kjaidev/Statistical-Characterization-Gm-C-Filter/README.md

# Statistical Characterization of a Gm-C Continuous-Time Filter in SKY130
Monte Carlo and PVT-corner study (BAECE203, VIT Chennai).
Team: Jaidev K, S Jai Akaash, Mohanakrishnan S, Jeswant P M. Guide: Dr. Brintha Therese A.

## Run the simulator (safe mode)
    GMC_FAKE=1 streamlit run apptest/gmc_app.py
Safe mode: Live tab is synthetic; other seven tabs read real saved results.

## Real live runs
Needs Docker image hpretl/iic-osic-tools (ngspice + SKY130A).
