kjaidev/Statistical-Characterization-Gm-C-Filter/fig_cm_compare.png

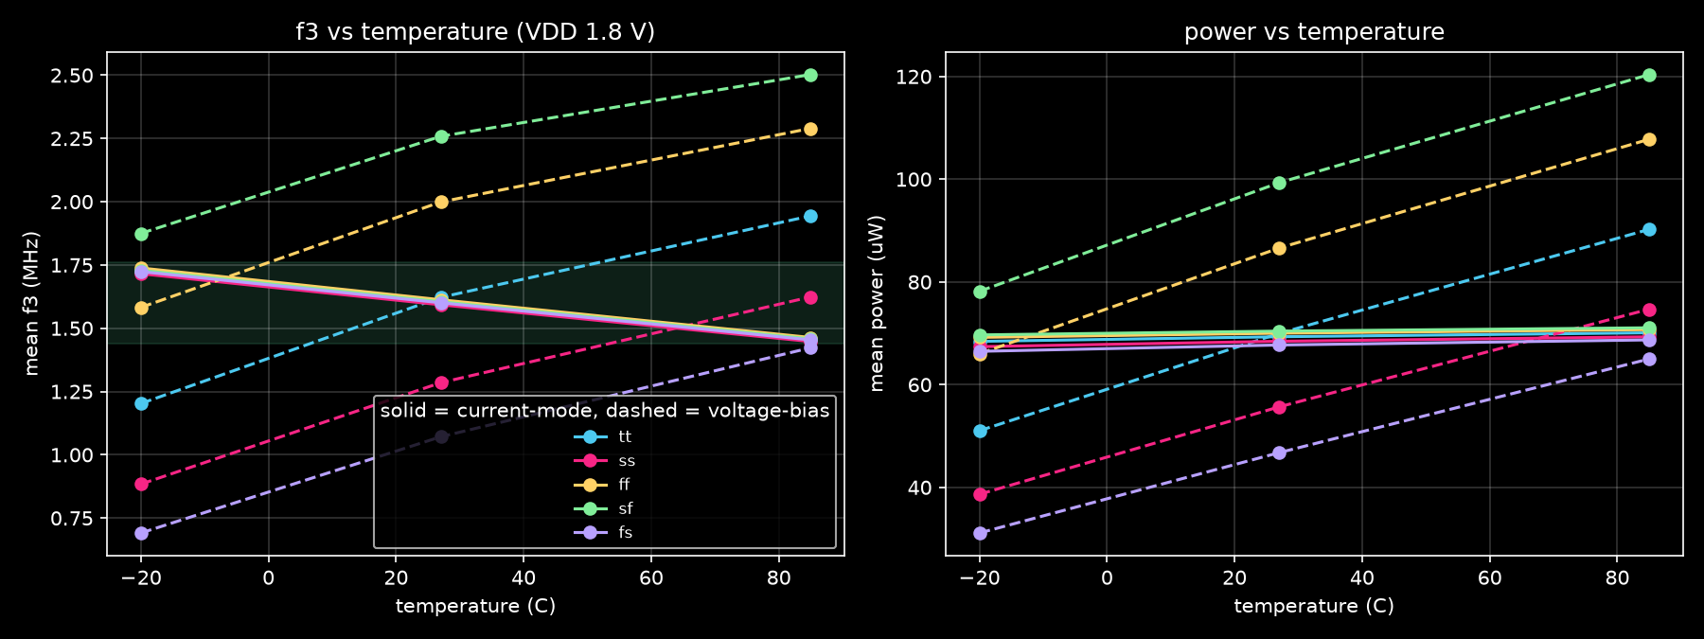
fig_cm_compare.png
