kjaidev/Statistical-Characterization-Gm-C-Filter/fig_cm_range.png

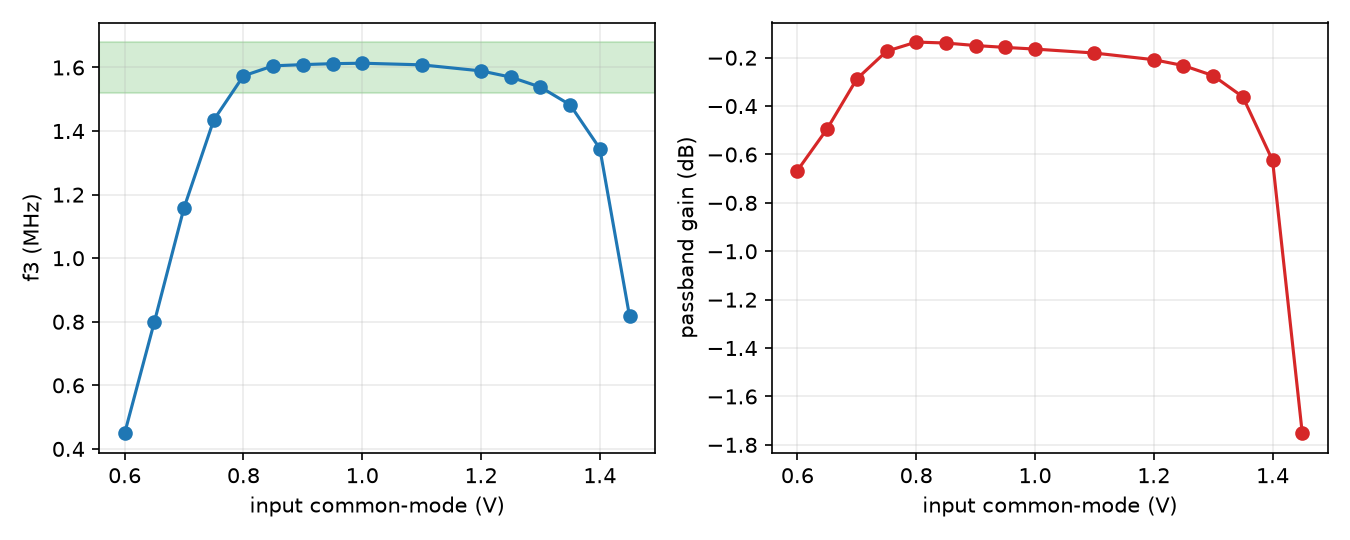
fig_cm_range.png
