kjaidev/Statistical-Characterization-Gm-C-Filter/fig_f3_corners.png

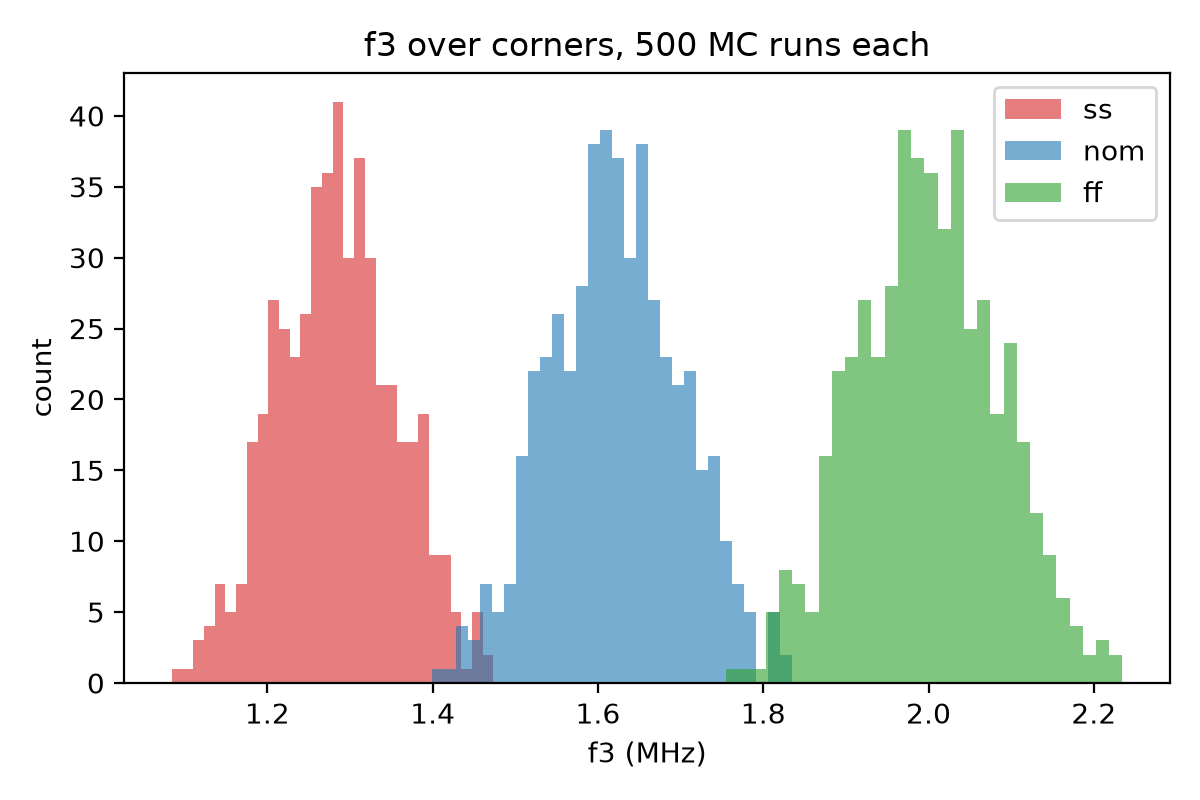
fig_f3_corners.png
