kjaidev/Statistical-Characterization-Gm-C-Filter/fig_grid_f3.png

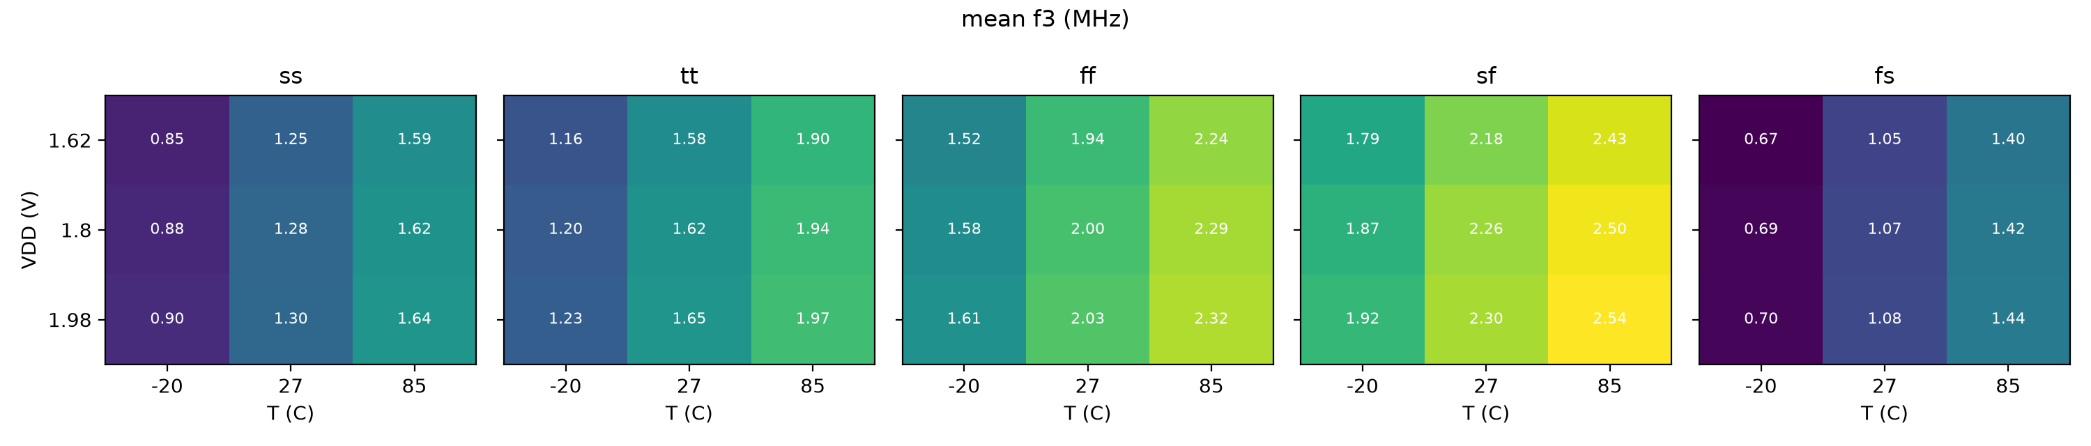
fig_grid_f3.png
