kjaidev/Statistical-Characterization-Gm-C-Filter/fig_grid_q.png

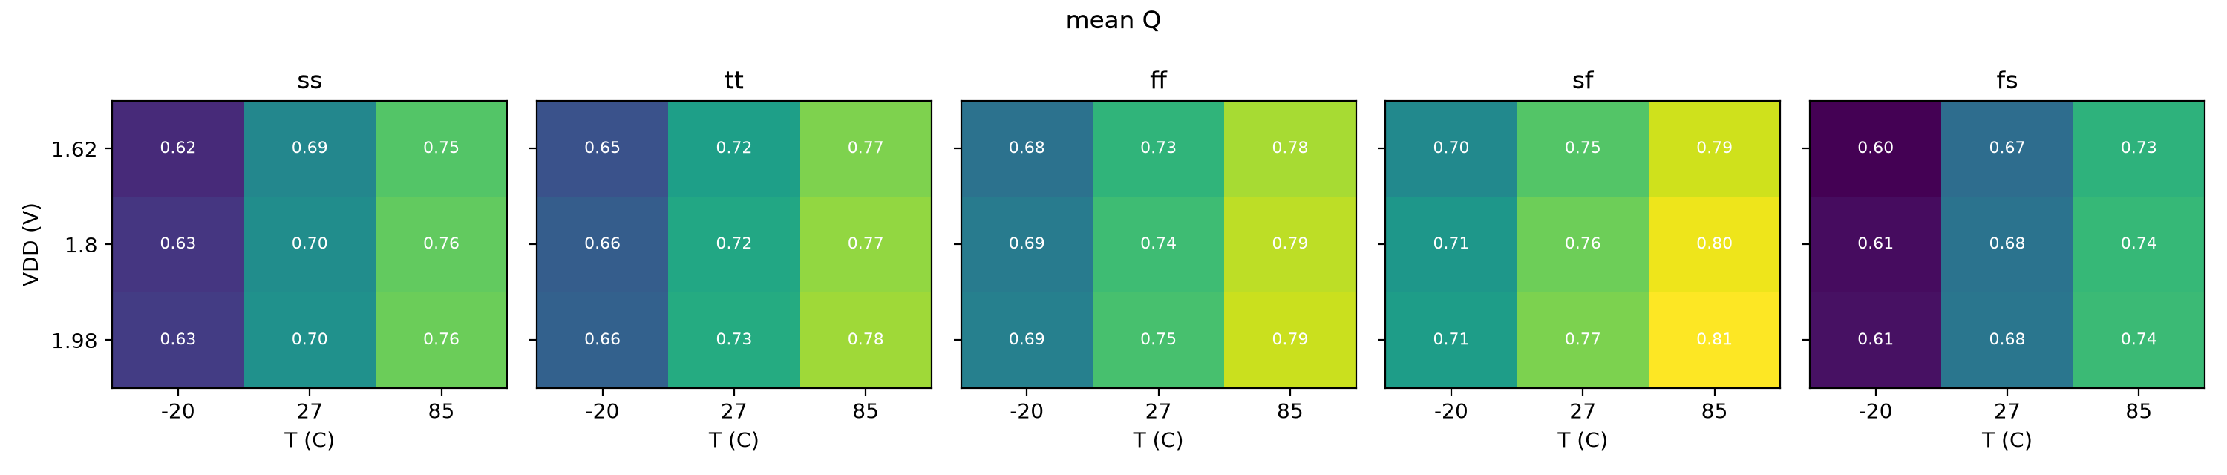
fig_grid_q.png
