kjaidev/Statistical-Characterization-Gm-C-Filter/fig_grid_yield.png

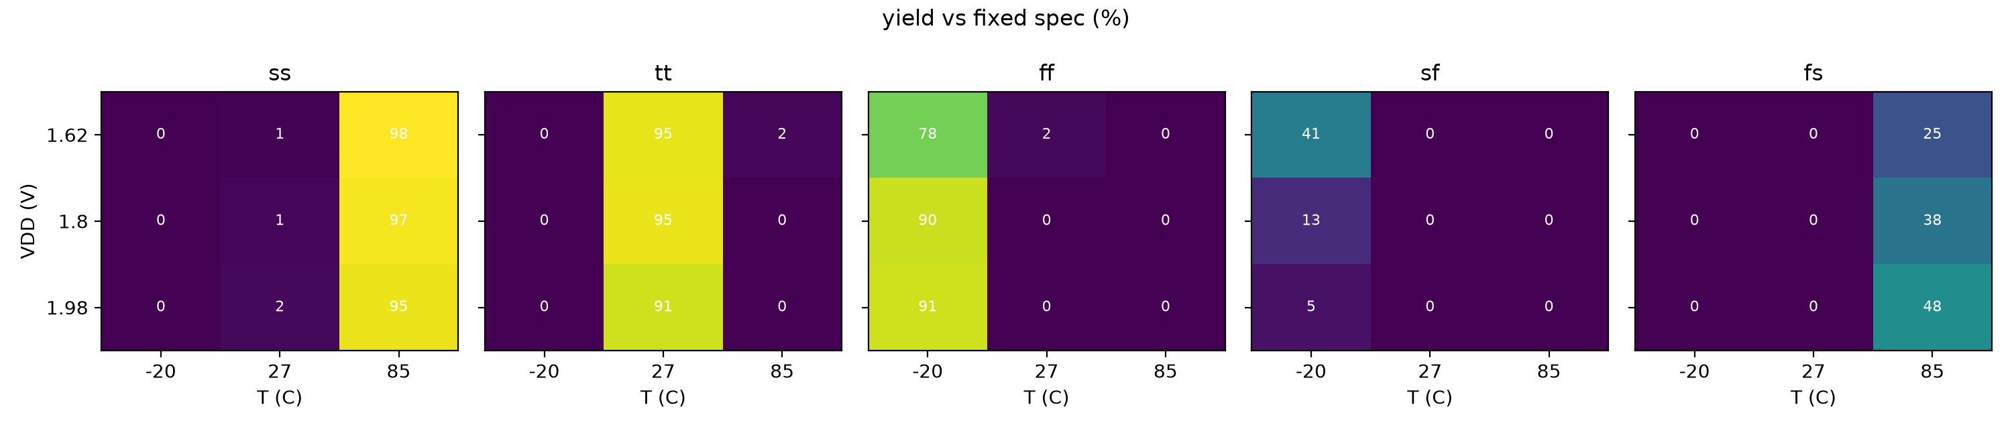
fig_grid_yield.png
