kjaidev/Statistical-Characterization-Gm-C-Filter/fig_noise.png

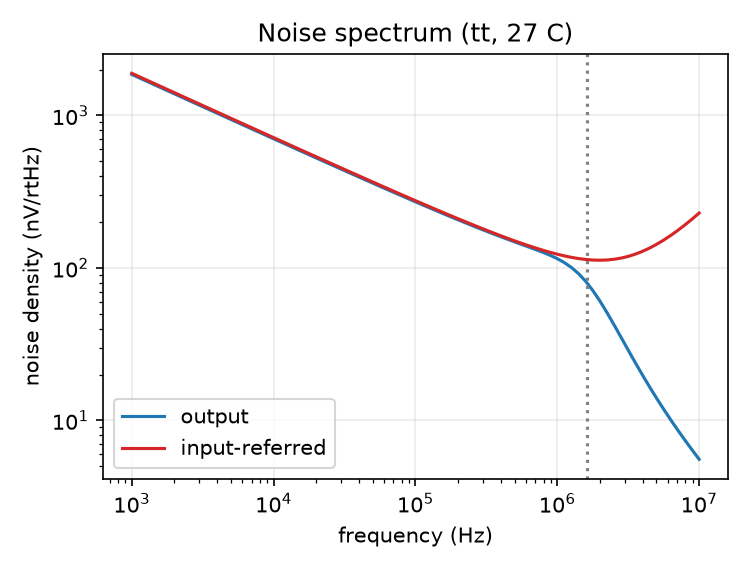
fig_noise.png
