kjaidev/Statistical-Characterization-Gm-C-Filter/fig_nominal_ac.png

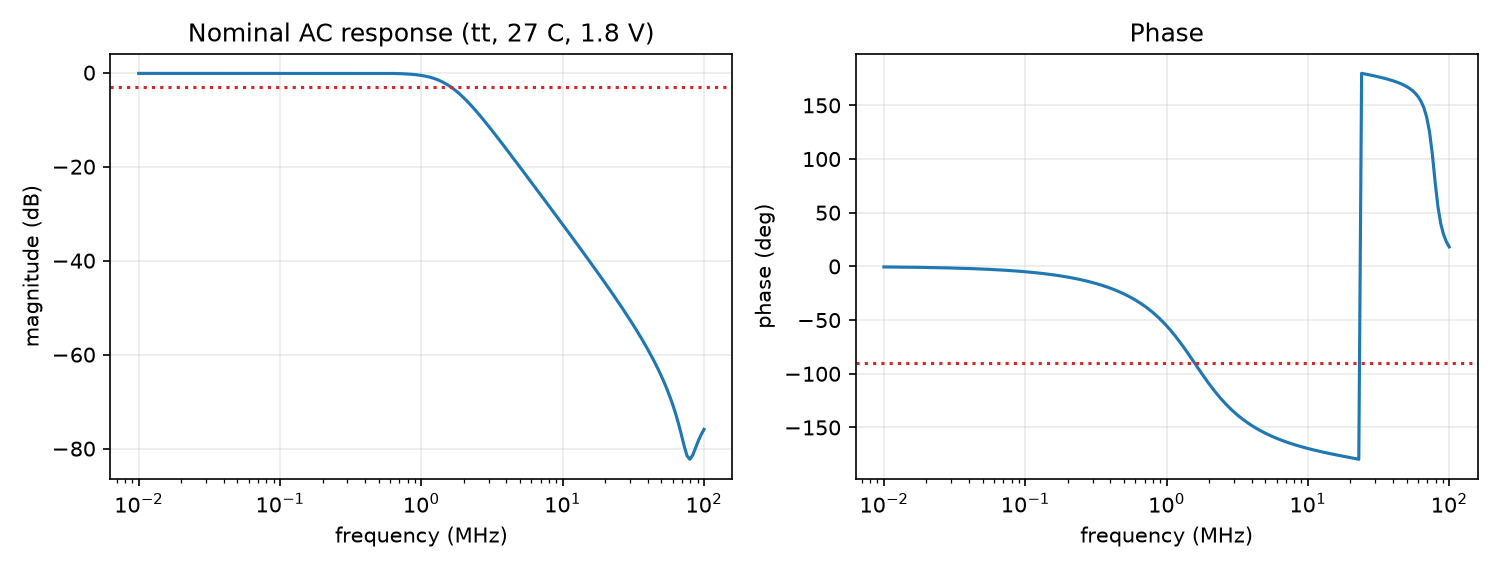
fig_nominal_ac.png
