kjaidev/Statistical-Characterization-Gm-C-Filter/fig_nominal_hist.png

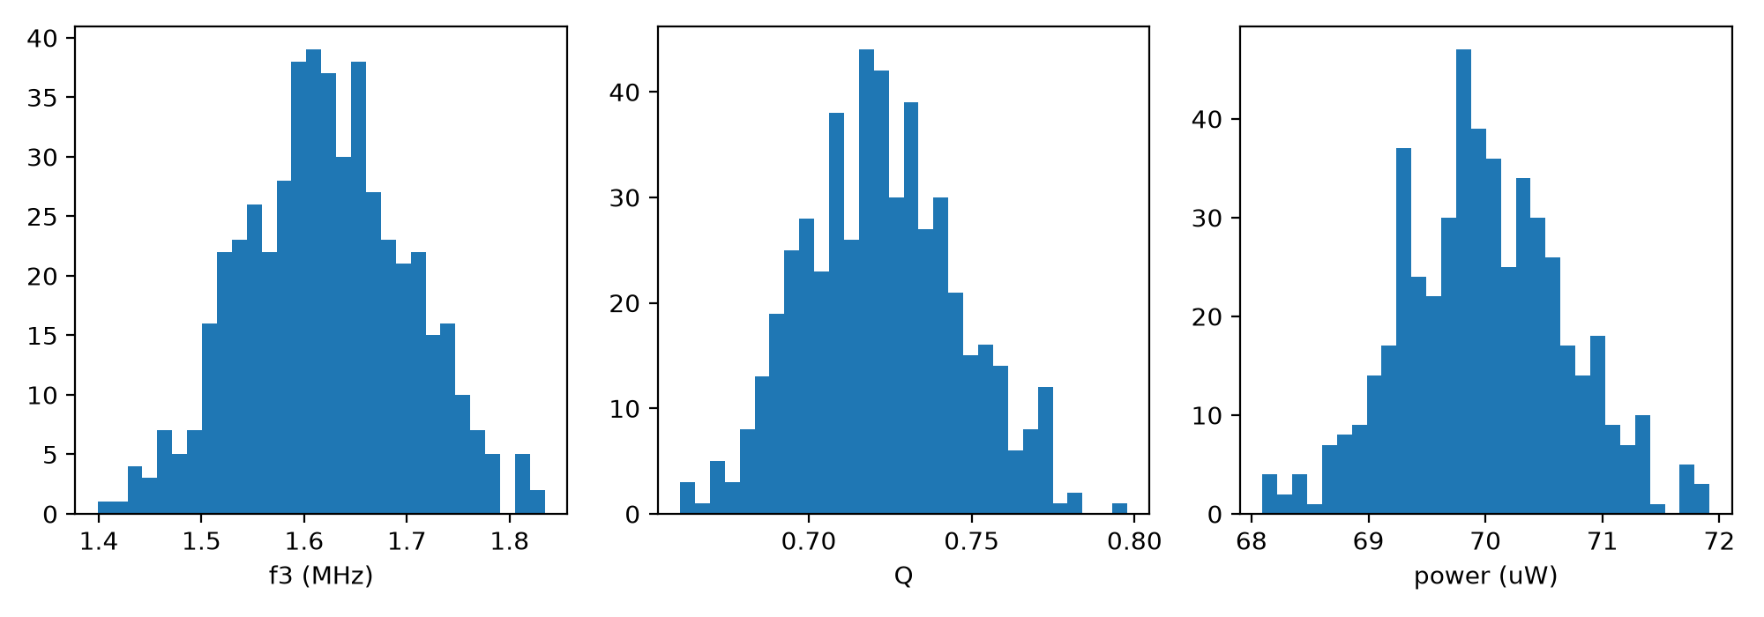
fig_nominal_hist.png
