kjaidev/Statistical-Characterization-Gm-C-Filter/fig_offset_hist.png

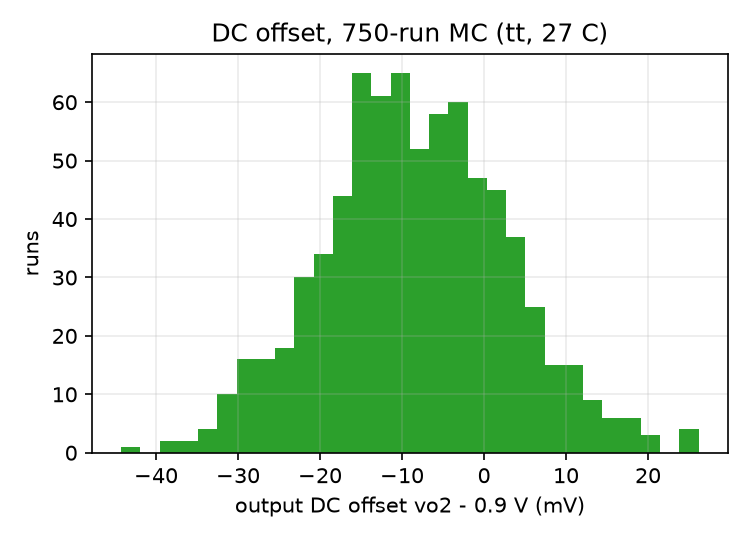
fig_offset_hist.png
