kjaidev/Statistical-Characterization-Gm-C-Filter/fig_pelgrom.png

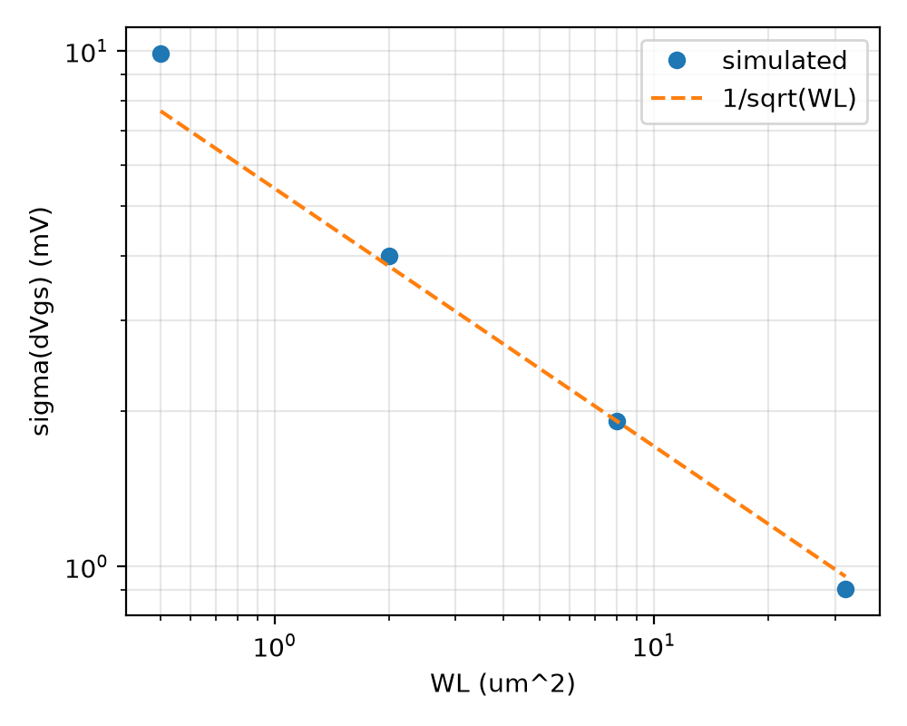
fig_pelgrom.png
