kjaidev/Statistical-Characterization-Gm-C-Filter/fig_pelgrom_handcalc.png

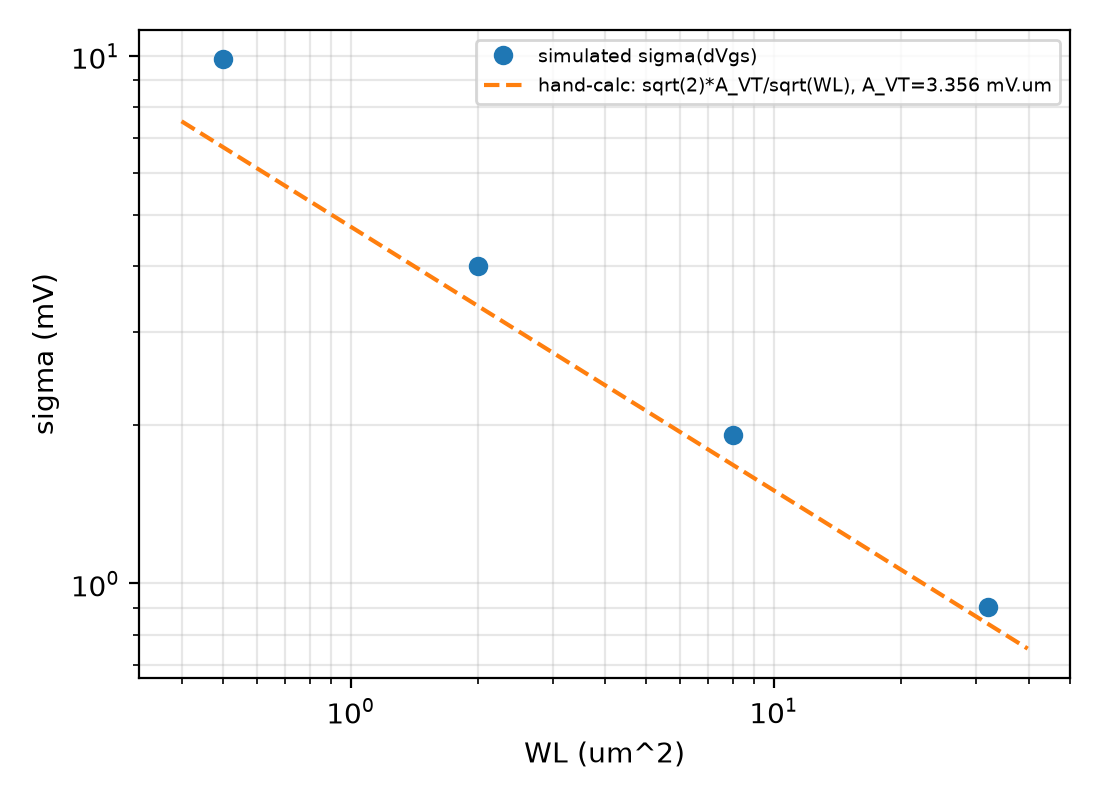
fig_pelgrom_handcalc.png
