kjaidev/Statistical-Characterization-Gm-C-Filter/fig_pt_compare.png

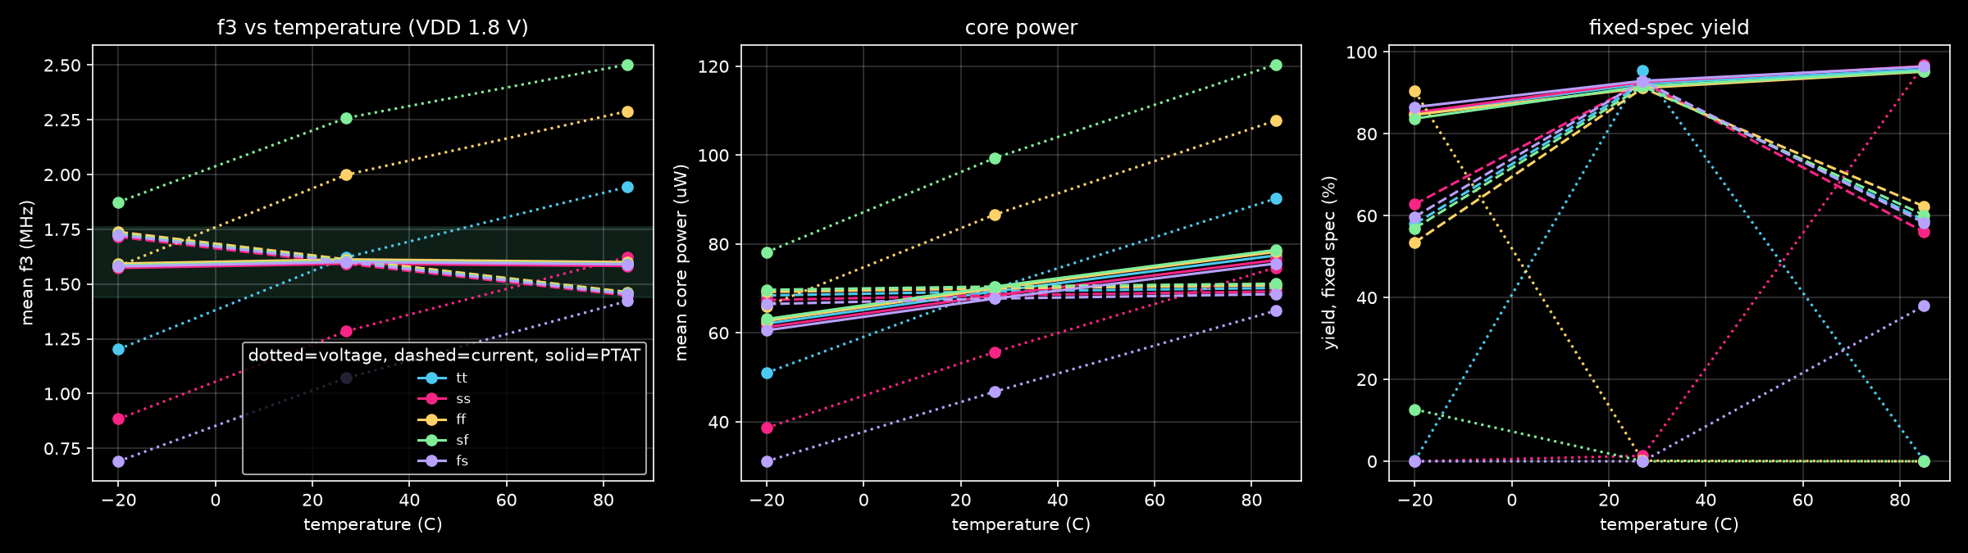
fig_pt_compare.png
