kjaidev/Statistical-Characterization-Gm-C-Filter/fig_pvt.png

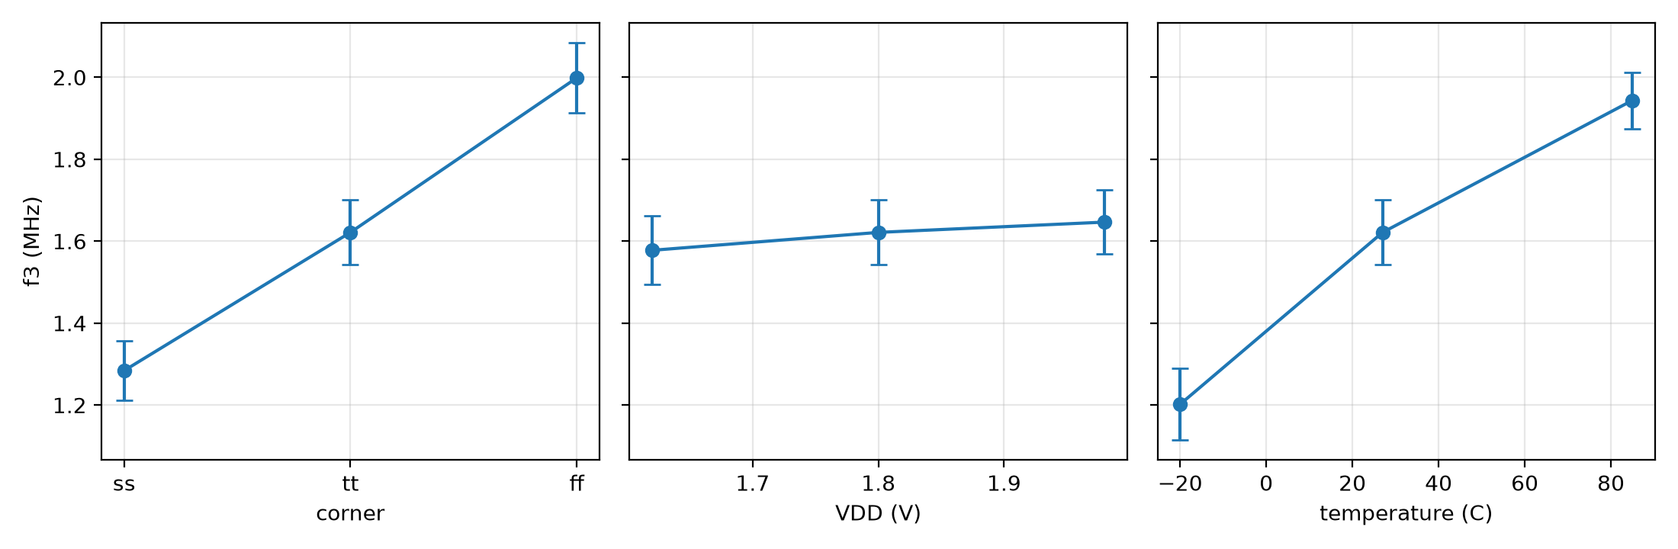
fig_pvt.png
