kjaidev/Statistical-Characterization-Gm-C-Filter/fig_ripple_hist.png

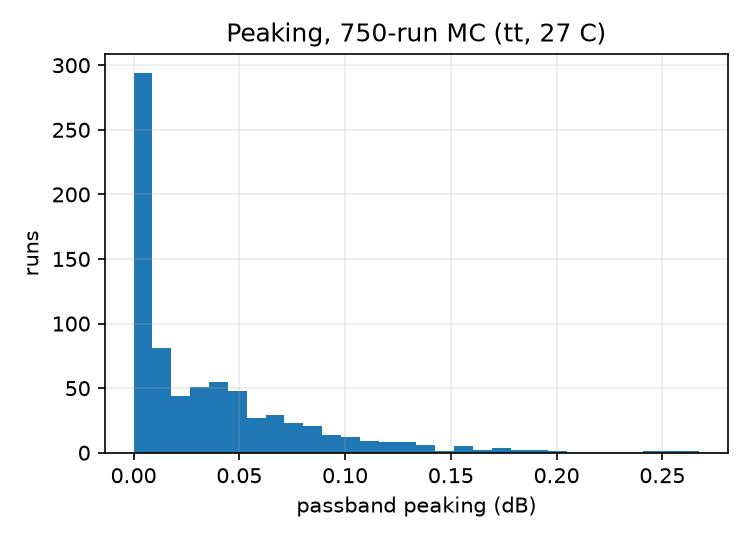
fig_ripple_hist.png
