kjaidev/Statistical-Characterization-Gm-C-Filter/fig_tran.png

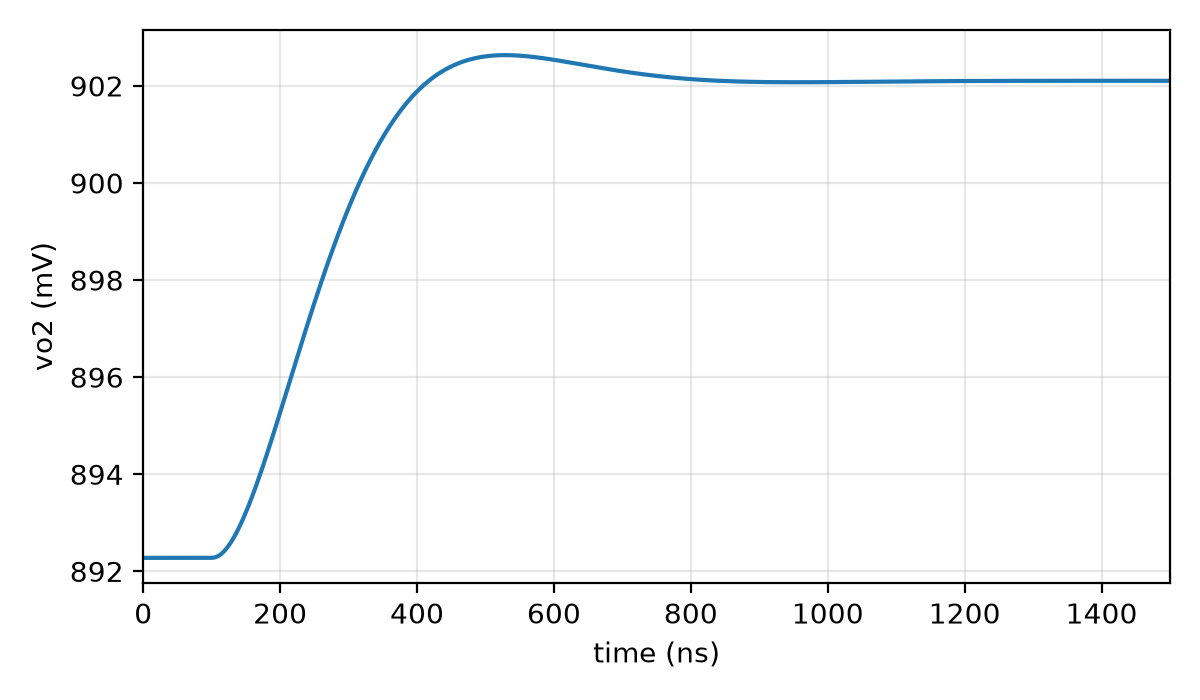
fig_tran.png
