kjaidev/Statistical-Characterization-Gm-C-Filter/results_package/table_TI.md

                     f3_mean_MHz  f3_sd_pct  Q_mean    Q_sd  rip_mean_dB  rip_sd_dB  rip_max_dB
nominal tt 1.8V 27C       1.6019     5.6364  0.7204  0.0258       0.0333     0.0433      0.3497
worst sf 1.62V -20C       1.5153     7.7865  0.6973  0.0305       0.0161     0.0336      0.3391

f3_cond_mean_min         1.5163
f3_cond_mean_max         1.6378
Q_cond_mean_min          0.6974
Q_cond_mean_max          0.7368
rip_cond_mean_min        0.0168
rip_cond_mean_max        0.0638
f3_run_min               1.0612
f3_run_max               1.9544
Q_run_min                0.5891
Q_run_max                0.8190
rip_run_min              0.0000
rip_run_max              0.3501
runs                 33750.0000
