kjaidev/Statistical-Characterization-Gm-C-Filter/results_package/tables.md

## Summary

         conditions     runs  mean_yield  min_yield  worst_f3_shift_MHz  mean_f3_sd_pct  worst_f3_sd_pct  Q_min  Q_max  P_min_uW  P_max_uW
design                                                                                                                                    
PTAT           45.0  33750.0      88.714     72.267               0.084           6.072            8.279  0.697  0.737    72.028   112.976
voltage        45.0  33750.0      22.424      0.000               0.944           5.319           10.224  0.598  0.806    27.992   132.520

## By corner

                f3_MHz  f3_sd_pct      Q    P_uW  yield_pct
design  corner                                             
PTAT    ff       1.595      6.184  0.712  92.024     88.281
        fs       1.586      5.897  0.727  89.672     89.881
        sf       1.586      6.238  0.713  92.437     87.526
        ss       1.577      5.962  0.725  90.409     89.096
        tt       1.587      6.076  0.718  91.319     88.785
voltage ff       1.949      4.569  0.736  86.795     29.022
        fs       1.058      6.623  0.672  47.628     12.370
        sf       2.200      4.158  0.755  99.285      6.504
        ss       1.259      6.002  0.695  56.342     32.711
        tt       1.583      5.241  0.717  70.415     31.511

## tt 1.8 V vs temperature

       f3_MHz              Q             P_uW         yield_pct        
design   PTAT voltage   PTAT voltage     PTAT voltage      PTAT voltage
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
mirror x4 -20C                  750   1.590      5.811  0.715  0.026  140.050     0.632      0.026     91.467     91.467
mirror x16 -20C                 750   1.579      5.817  0.712  0.026  374.097     0.213      0.021     90.267     90.267
