kjaidev/Statistical-Characterization-Gm-C-Filter/results_package/table_all_conditions.csv

n | f3_MHz | f3_sd_pct | Q | Q_sd | P_uW | P_sd_pct | ripple_dB | yield_pct | f3_in_pct | design | corner | VDD | T
750 | 1.1569 | 8.101 | 0.6509 | 0.0277 | 45.9062 | 1.2675 | 0.0004 | 0.1333 | 0.1333 | voltage | tt | 1.62 | -20
750 | 1.5782 | 5.2345 | 0.7158 | 0.0232 | 62.9497 | 1.0161 | 0.0255 | 94.5333 | 94.5333 | voltage | tt | 1.62 | 27
750 | 1.9011 | 3.6832 | 0.7659 | 0.0198 | 81.1558 | 0.8112 | 0.1387 | 1.8667 | 1.8667 | voltage | tt | 1.62 | 85
750 | 1.2024 | 7.134 | 0.6593 | 0.027 | 51.0277 | 1.2677 | 0.0008 | 0.1333 | 0.1333 | voltage | tt | 1.8 | -20
750 | 1.622 | 4.8175 | 0.7226 | 0.0231 | 69.9797 | 1.0166 | 0.0339 | 95.4667 | 95.4667 | voltage | tt | 1.8 | 27
750 | 1.9441 | 3.4883 | 0.7725 | 0.02 | 90.2372 | 0.812 | 0.1606 | 0.1333 | 0.1333 | voltage | tt | 1.8 | 85
750 | 1.2269 | 6.7034 | 0.663 | 0.0272 | 56.1495 | 1.2679 | 0.0011 | 0.1333 | 0.1333 | voltage | tt | 1.98 | -20
750 | 1.647 | 4.629 | 0.7259 | 0.0233 | 77.0092 | 1.0169 | 0.0397 | 91.2 | 91.2 | voltage | tt | 1.98 | 27
750 | 1.9707 | 3.3814 | 0.776 | 0.0202 | 99.3168 | 0.8125 | 0.1753 | 0.0 | 0.0 | voltage | tt | 1.98 | 85
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
