kjaidev/Statistical-Characterization-Gm-C-Filter/results_package/table_by_corner.csv

design | corner | f3_MHz | f3_sd_pct | Q | P_uW | yield_pct
PTAT | ff | 1.595 | 6.184 | 0.712 | 92.024 | 88.281
PTAT | fs | 1.586 | 5.897 | 0.727 | 89.672 | 89.881
PTAT | sf | 1.586 | 6.238 | 0.713 | 92.437 | 87.526
PTAT | ss | 1.577 | 5.962 | 0.725 | 90.409 | 89.096
PTAT | tt | 1.587 | 6.076 | 0.718 | 91.319 | 88.785
voltage | ff | 1.949 | 4.569 | 0.736 | 86.795 | 29.022
voltage | fs | 1.058 | 6.623 | 0.672 | 47.628 | 12.37
voltage | sf | 2.2 | 4.158 | 0.755 | 99.285 | 6.504
voltage | ss | 1.259 | 6.002 | 0.695 | 56.342 | 32.711
voltage | tt | 1.583 | 5.241 | 0.717 | 70.415 | 31.511
