kjaidev/Statistical-Characterization-Gm-C-Filter/results_package/fig2_yield_by_corner.png

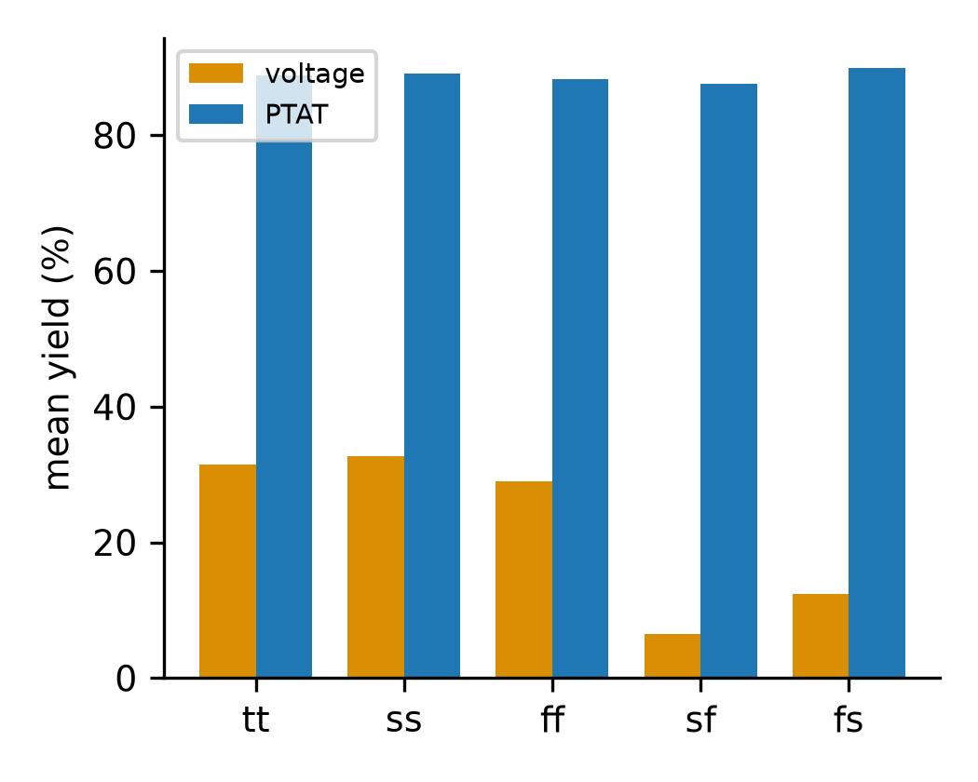
results_package/fig2_yield_by_corner.png
